paramworks-git/param-pod/3d-printing/cap_tree_nubs_30_45.stl

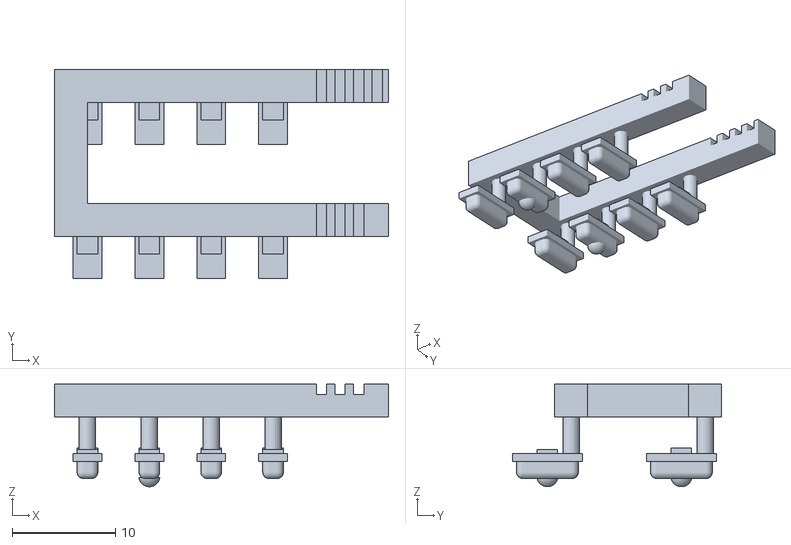
[picture p4: CAD file, 2026-11-02]
3d-printing/cap_tree_nubs_30_45.stl
32.4 x 20.3 x 9.95
