paramworks-git/param-pod/3d-printing/pod_box.stl

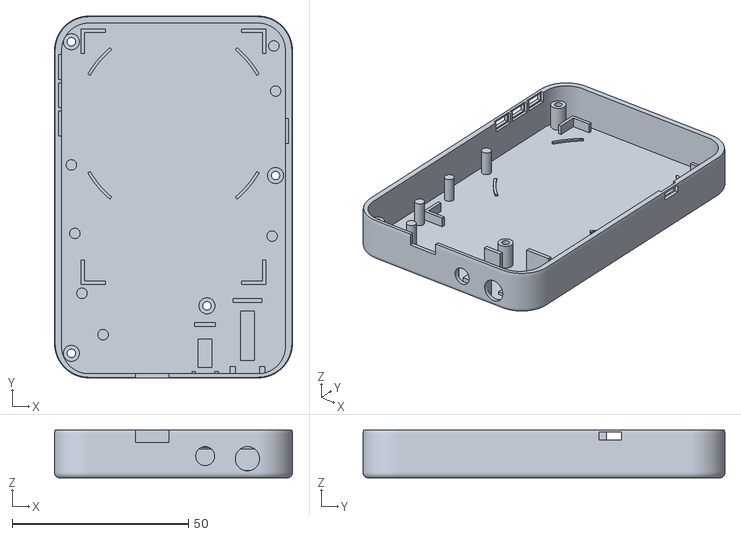
[picture p5: CAD file, 2026-11-02]
3d-printing/pod_box.stl
67.6 x 102.8 x 13.6
