paramworks-git/param-pod/3d-printing/pod_lid.stl

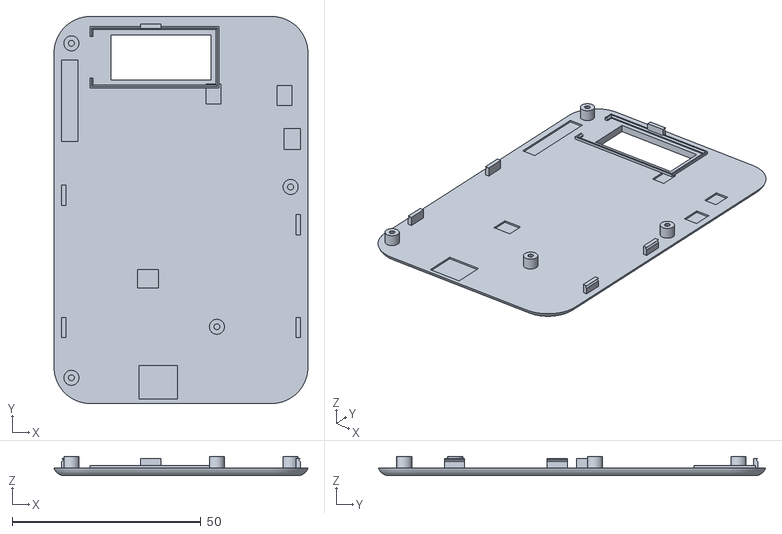
[picture p6: CAD file, 2026-11-02]
3d-printing/pod_lid.stl
67.2 x 102.4 x 5.15
