paramworks-git/param-pod/(list of files, cad)

Other CAD files:
3d-printing/cap_tree_nubs_0_15.stl
