paramworks-git/param-pod/schematics/param-pod-schematic.pdf

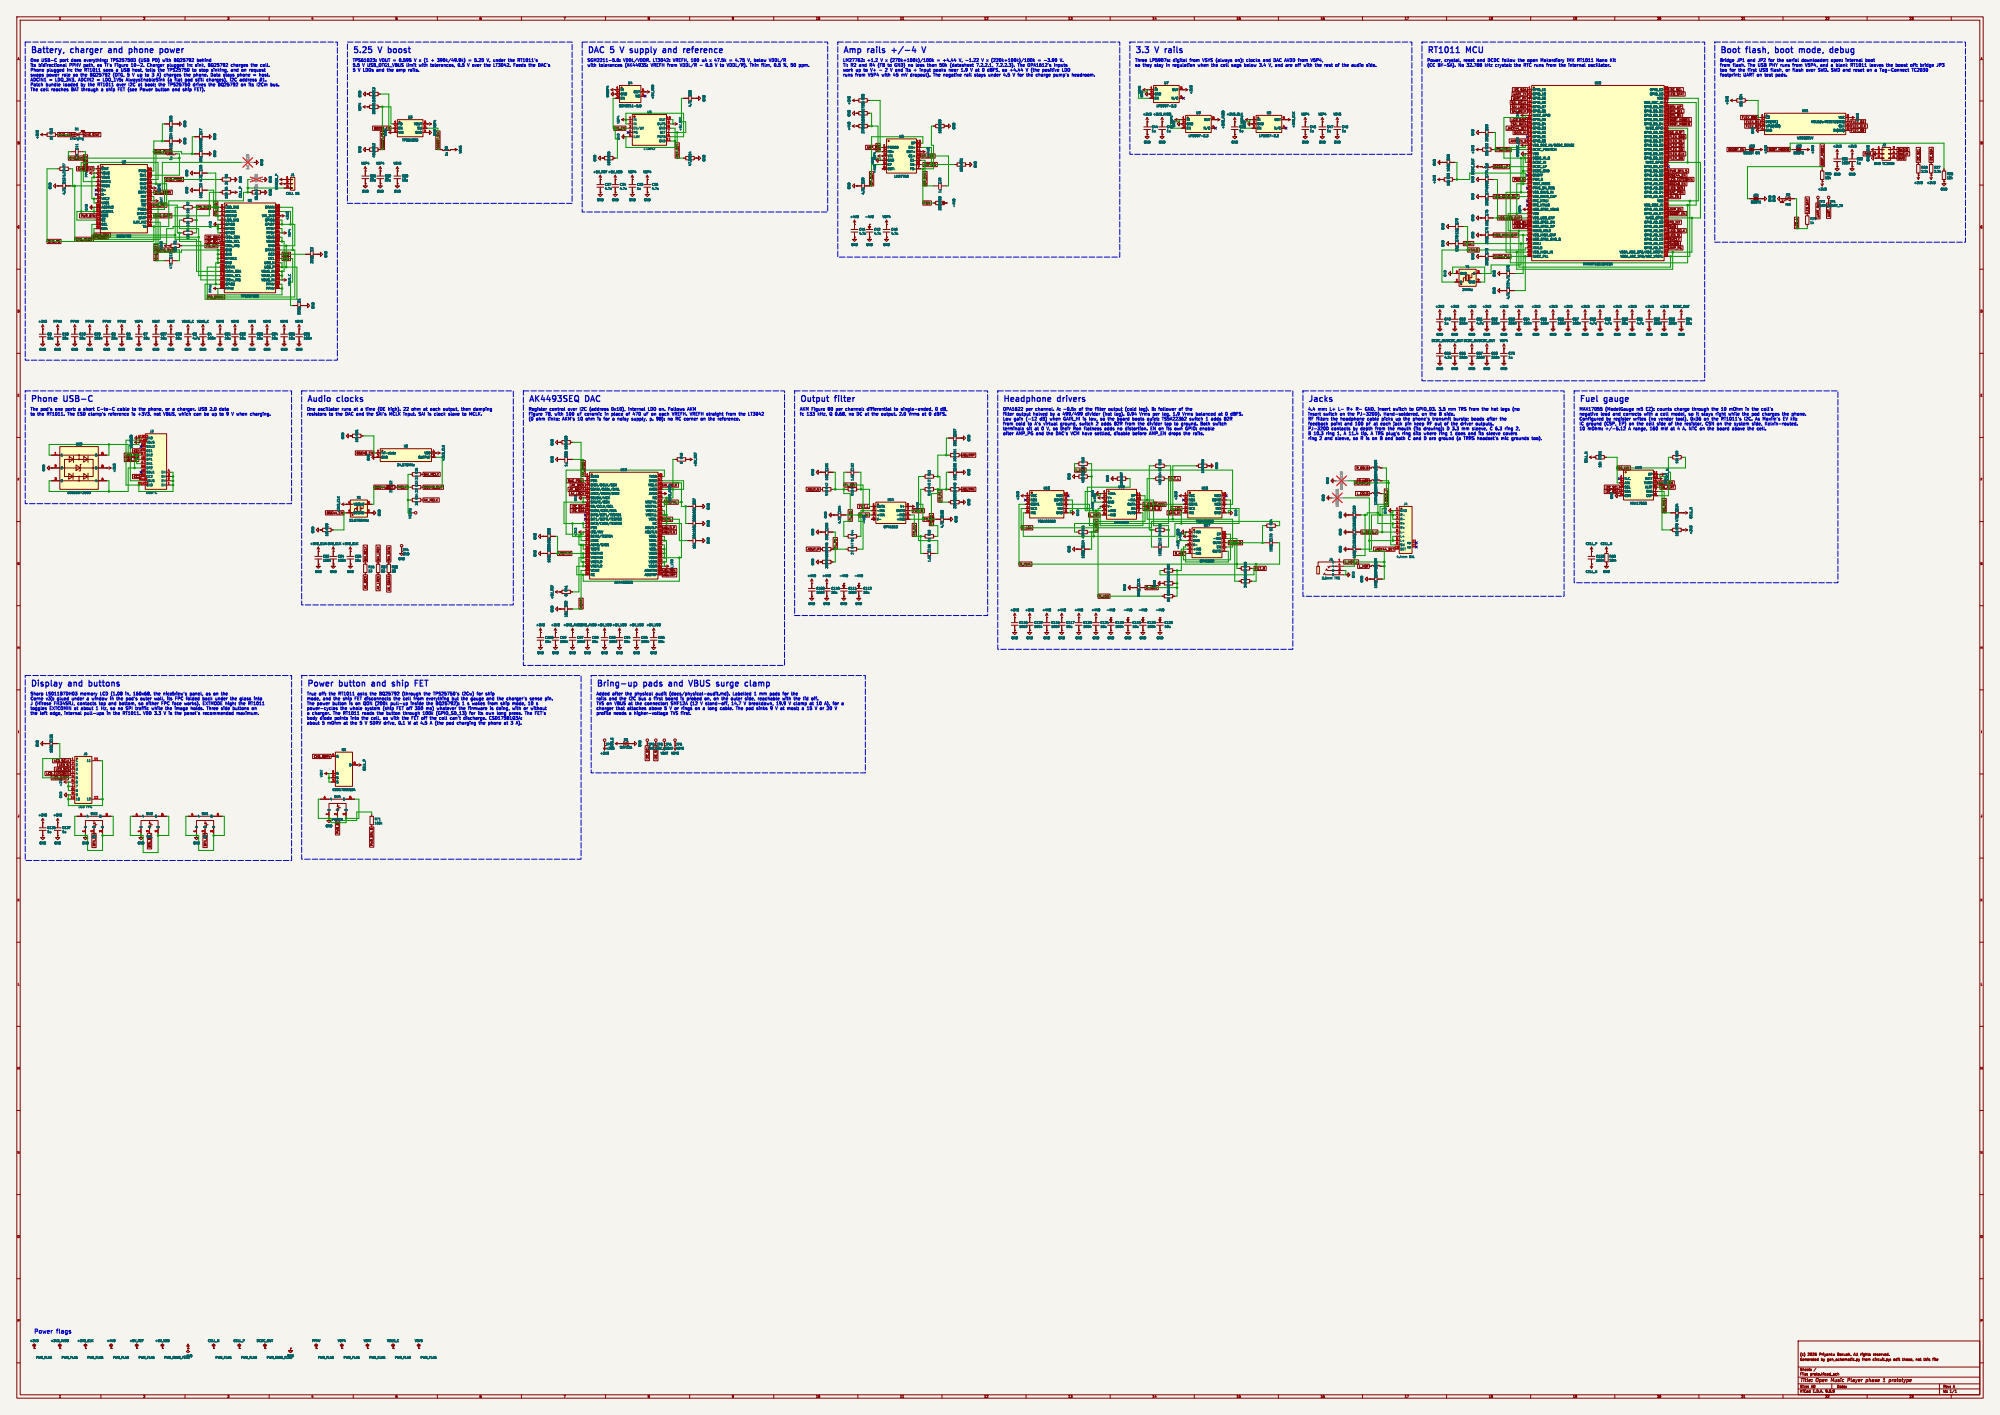
[picture p7: page 1]

Battery, charger and phone power

DAC 5 V supply and reference

Boot flash, boot mode, debug

Phone plugged in: the RT1011 sees a USB host, tells the TPS25750 to stop sinking, and on request
swaps power role so the BQ25792 (OTG, 5 V up to 3 A) charges the phone. Data stays phone = host.
Patch bundle loaded by the RT1011 over I2C at boot; the TPS25750 drives the BQ25792 on its I2Cm bus.
The cell reaches BAT through a ship FET (see Power button and ship FET).

5 V LDOs and the amp rails.

work up to V+ - 2 V and its + input peaks near 1.9 V at 0 dBFS, so +4.44 V (the positive LDO

Power, crystal, reset and DCDC follow the open Makerdiary iMX RT1011 Nano Kit

from flash. The USB PHY runs from V5P4, and a blank RT1011 leaves the boost off: bridge JP3

2.2k +3V3 ~{CS} 1 DO(IO1) 2 WP#(IO2) 3 GND

~{CS} 1 DO(IO1) 2 WP#(IO2) 3 GND

to the RT1011. The ESD clamp's reference is +3V3, not VBUS, which can be up to 9 V when charging.
U12 USBLC6-2SC6

fc 133 kHz, Q 0.68, no DC at the output. 2.0 Vrms at 0 dBFS.

from cold to A's virtual ground, switch 2 adds 82R from the divider tap to ground. Both switch
after AMP_PG and the DAC's VCM have settled, disable before AMP_EN drops the rails.

4.4 mm: L+ L- R+ R- GND, insert switch to GPIO_03. 3.5 mm TRS from the hot legs (no
feedback point and 100 pF at each jack pin keep RF out of the driver outputs.
B 10.3 ring 1, A 11.4 tip. A TRS plug's ring sits where ring 1 does and its sleeve covers

MAX17055 (ModelGauge m5 EZ): counts charge through the 10 mOhm in the cell's

(0 ohm links; AKM's 10 ohm is for a noisy supply, p. 98): no RC corner on the reference.

DVDD 1 PDN 2 BICK/DCLK/BCK 3 SDATA/DSDL/DINL 4

LRCK/DSDR/DINR 5 SSLOW/WCK 6 SMUTE/CSN 7 SD/CCLK/SCL 8 SLOW/CDTI/SDA 9 DIF0/DZFL/TESTO1 10 DIF1/DZFR/TESTO2 11 DIF2/CAD0/TESTO3 12 PSN 13

Power button and ship FET

Corne v3): glued under a window in the pod's outer wall, its FPC folded back under the glass into

charger that attaches above 5 V or rings on a long cable. The pod sinks 9 V at most; a 15 V or 20 V

Id: 1/1 Title: Open Music Player phase 1 prototype
