paramworks-git/param-pod/(commit log)

2026-11-02 Initial sanitized open-source release of PARAM POD: schematics, MagSafe case STLs, UAC2 firmware, and documentation
    [cap_tree_nubs_0_15.stl, cap_tree_nubs_30_45.stl, pod_box.stl, pod_lid.stl]
2026-11-02 docs: add product and black ENIG PCB renders, simplify header, incorporate user edits
